JackobPunch/WIM-Signal-Simulator/data/Wyniki_testów/2024_07_03/2024_07_03.csv

Id | Lane Nr | Date | Vehicle Class | BAST | Speed | Scale Speed | Length LOOP[m] | Axis Count | Height[cm] | Optical Length[cm] | Air Temp | Road Temp | Wind Direction | Wind Speed | Weight Total | Weight Each wheel | Axis1R | Axis1L | Axis2R | Axis2L | Axis3R | Axis3L | Axis4R | Axis4L | Axis5R | Axis5L | Axis6R | Axis6L | Axis7R | Axis7L | Axis8R | Axis8L | Axis9R | Axis9L | Axis10R | Axis10L | Axis11R | Axis11L | Axis12R | Axis12L | Axis13R | Axis13L | Axis14R | Axis14L | Axis15R | Axis15L | Axis16R | Distance beetween Axis | Axis 1->Axis2 | Axis 2->Axis3 | Axis 3->Axis4 | Axis 4->Axis5 | Axis 5->Axis6 | Axis 6->Axis7 | Axis 7->Axis8 | Axis 8->Axis9 | Axis 9->Axis10 | Axis 10->Axis11 | Axis 11->Axis12
10 | 1 | 2024-07-03 11:42:22Z | 4 | 32 | 30 | 30 | 2540 | 5 | 0 | 0 | 0 | 0 | 0 | 0 | 32070 |  | 3000 | 3000 | 4182 | 4182 | 2835 | 2835 | 2973 | 2973 | 3045 | 3045 | 0 | 0 | 0 | 0 | 0 | 0 | 0 | 0 | 0 | 0 | 0 | 0 | 0 | 0 | 0 | 0 | 0 | 0 | 0 | 0 | 0 | 0 |  | 219 | 318 | 82 | 82 | 0 | 0 | 0 | 0 | 0 | 0
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
