JackobPunch/WIM-Signal-Simulator/(commit log)

2024-12-17 wyniki testów
    [2023_03_20.csv, 2023_05_09.csv, 2023_05_10.csv, 2023_05_15.csv, 2024_06_24.csv, 2024_07_03.csv, 2024_07_09 — kopia.csv, 2024_07_09-old.csv]
2024-12-18 analiza testów
    [2023_03_20.csv, 2023_05_09.csv, 2023_05_10.csv, 2023_05_15.csv, 2024_06_24.csv, 2024_07_03.csv, 2024_07_09 — kopia.csv, 2024_07_09-old-1-analiza.csv]
2026-06-06 Rename sketches to descriptive names, remove junk files
    - firstBoss → semi_trailer_generator (main simulation firmware)
    - firstBoss2 → semi_trailer_generator_v2 (improved delay/relay version)
    - firstBoss2square → semi_trailer_square_wave_test (rectangular signal test)
    - firstBossMD → semi_trailer_relay_test (active relay + square wave)
    - Remove Thumbs.db and .vscode debug state files
    - Add .gitignore for Thumbs.db and .vscode/
